michael-gebis/sashiko/(list of files, cad)

Other CAD files:
fundo_tsunagi.scad
juji_hanazashi.scad
kikko.scad
kuginuki.scad
masu.scad
yotsume_goushi.scad
