michael-gebis/sashiko/(commit log)

2026-06-10 Initial commit: sashiko OpenSCAD stitch-guide templates
    55 traditional Japanese sashiko patterns as 3D-printable marking plates, on a shared 2D library (sashiko_lib.scad) and centralized config (sashiko_config.scad). Includes a Makefile build (auto-discovers patterns, STLs into build/, gallery previews) and gen_index.py, which regenerates the gallery index from each file's Description: comment.
    [amime.scad, asanoha.scad, bishamon_kikko.scad, fundo_tsunagi.scad, genjiguruma.scad, genjiko.scad, hana_shippo.scad, hanabishi.scad]
2026-06-10 Trim gallery intro prose
    End the first line at 'actual plate geometry', and simplify the 3D blurb to 'showing the plate thickness' (drop the specific value and the colour note).
2026-06-11 Add LICENSE and CI, dedupe lib helpers, centralize bridge_w, add registration
    Review follow-ups (#1-3, #5):
    - LICENSE: MIT, plus a README License section.
    - Library: factor the duplicated corner-gap segment and hexagon outline into
    sashiko_lib (corner_seg, hex_outline); templates now call thin wrappers.
    - Config: centralize bridge_w (was an identical 1.4 across 8 files).
    - CI: GitHub Action runs make verify (every pattern renders Volumes: 2) on push/PR.
    - Registration: opt-in reg flag cuts datum holes at the pattern-window corners for
    tiling across plate placements; off by default.
    No rendered output changed: the dedup and reg=false are byte-identical no-ops
    (verified via make verify an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
    [amime.scad, asanoha.scad, bishamon_kikko.scad, fundo_tsunagi.scad, genjiguruma.scad, genjiko.scad, hana_shippo.scad, hanabishi.scad]
2026-06-12 Docs: refresh library table, de-stale techniques, add Known limitations
    - Shared-library table: add corner_seg and hex_outline; fix the sashiko_plate
    signature (chamfer + reg).
    - Connectivity section: drop the stale 'three techniques' framing, tie it to
    corner_seg/hex_outline, add the encloses-nothing case.
    - Fix pattern count (54 -> 55).
    - New 'Known limitations & future work' section (print-fragility audit,
    authenticity, ergonomics) as revisit starting points.
2026-06-12 Add min-wall print-fragility audit (make audit + CI gate)
    Volumes: 2 proves each plate is one solid; this covers the other half of
    printability: nothing in the solid is too thin. The plates are uniform
    extrusions, so a full-plate orthographic top render IS the 2D geometry:
    audit_minwall.py segments it (ImageMagick + numpy FFT morphology, no new
    deps), calibrates mm/px from the 100 mm footprint, and binary-searches the
    smallest width whose opening removes a significant piece of solid - the
    thinnest unsupported wall/neck/wedge. Per-pattern values are committed in
    minwall_baseline.json; make audit (and a new CI job) fails on any regression
    beyond 0.15 mm. make audit-baseline refreshes it after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
2026-06-12 Fix hairline anchors in 6 patterns; audit gains min-link metric
    User-spotted: genjiguruma's diagonal spokes reach the rim exactly at the
    bridge angles, so each spoke tip punched through its bridge tab and left two
    ~0.1 mm straps as the wheel interior's only anchor. Volumes: 2 passes (any
    nonzero connection counts) and the min-wall audit filtered the straps as
    supported short necks - a blind spot between the two gates.
    audit_minwall.py now reports a second width per pattern: min link, the
    smallest w whose erosion alone splits the solid - the thinnest load-bearing
    connection, however short. It flags the pre-fix genjiguruma at <= 0.11 mm and
    reads as the designed bridge/neck width on healthy p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
    [genjiguruma.scad, kagome.scad, kanoko.scad, mitsuuroko.scad, sashiko_lib.scad, tumbling_blocks.scad, uroko.scad]
2026-06-12 genjiguruma: restore diagonal rim breaks, sized for real straps
    Return the bridges to the spoke angles [45,135,225,315] - the original
    look, with the diagonal spoke tips floating in the rim breaks - but derive
    the break width from a new strap param instead of bridge_w: the arcs are
    trimmed so each tip leaves strap = 0.65 mm of solid either side (the stock
    trim left 0.099 mm). Verified Volumes: 2; audit reads min wall 0.82 /
    min link 0.64 (the straps, as designed); baseline updated.
    [genjiguruma.scad]
2026-06-12 Add 6 patterns: sankuzushi, higaki, dan-tsunagi, itomaki, ogi-tsunagi, hougan
    A hitomezashi/weave-leaning wave, plus a practical jig:
    - sankuzushi (三崩し) - triple basket weave; open dashes, no bridges.
    - higaki (檜垣) - cypress-fence woven planks; open 45-deg dashes.
    - dan_tsunagi (段つなぎ) - linked staircase polylines.
    - itomaki (糸巻き) - waisted thread spools, corner gaps sized per vertex
    angle (1.7 mm at the 63-deg flange corners, 1.0 mm at the 127-deg waist).
    - ogi_tsunagi (扇つなぎ) - folding fans with floating ribs (kept 2 mm clear
    of both arcs - the genjiguruma lesson applied at design time).
    - hougan (方眼) - a plain 5 mm dot-grid jig for marking counted hit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
    [dan_tsunagi.scad, higaki.scad, hougan.scad, itomaki.scad, ogi_tsunagi.scad, sankuzushi.scad]
2026-06-12 Add 5 patterns: sorobandama, zenizashi, hirayama-michi, inazuma, egasumi
    Wave 2 from the backlog:
    - sorobandama (算盤玉) - abacus-bead diamond columns; corner gaps per vertex
    angle (1.5 mm at the 77-deg tips, 1.2 mm at the 103-deg sides).
    - zenizashi (銭刺し) - mon-coin grid: bridged ring + corner-gapped square
    hole, tabs on the diagonals away from the square.
    - hirayama_michi (平山道) - flat-topped trapezoid waves, open polylines.
    - inazuma (稲妻) - stepped chevron lightning bolts, open polylines.
    - egasumi (絵霞) - staggered mist bands, open polylines.
    Also promotes itomaki's asymmetric corner gap into the lib as corner_seg2
    (corner_seg now delegates to it; itomaki byte-i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
    [egasumi.scad, hirayama_michi.scad, inazuma.scad, itomaki.scad, sashiko_lib.scad, sorobandama.scad, zenizashi.scad]
2026-06-13 Add release workflow: attach sashiko-stl-<tag>.zip to GitHub releases
    Publishing a release builds every pattern's STL and uploads one zip
    (all STLs + LICENSE) as a release asset; workflow_dispatch backfills
    existing releases.
2026-06-13 README: link to the STL zip on the latest release
    Adds a "Download the STLs" call-to-action next to the gallery link,
    pointing at releases/latest so it tracks new releases automatically.
2026-06-16 Resize templates to 120×120×0.8 mm
    Bump the plate to 120 mm square and 0.8 mm thick (chamfer 0.3 to stay <= t/2). Patterns auto-fill the larger window; all 66 still render Volumes: 2.
    Re-centre the gallery/audit cameras on the new plate centre, fix the audit calibration (PLATE_MM 100 -> 120), refresh the min-wall baseline, and sync the README dimensions (size, thickness, 108 mm tiling pitch).
    [sashiko_config.scad]
